sandrokleinbauer-lang/Test/lillabo-male-male/export/Gerade_MM.step

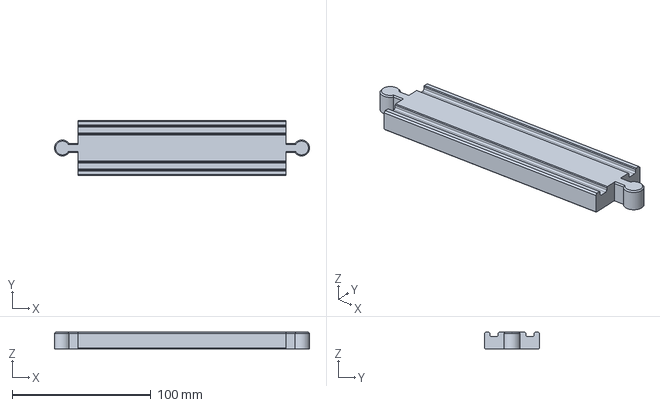
[picture p2: CAD file, 2026-10-17]
lillabo-male-male/export/Gerade_MM.step
184.0 x 40.0 x 12.0 mm
