sandrokleinbauer-lang/Test/lillabo-male-male/Lillabo_Stecker_Stecker.FCStd

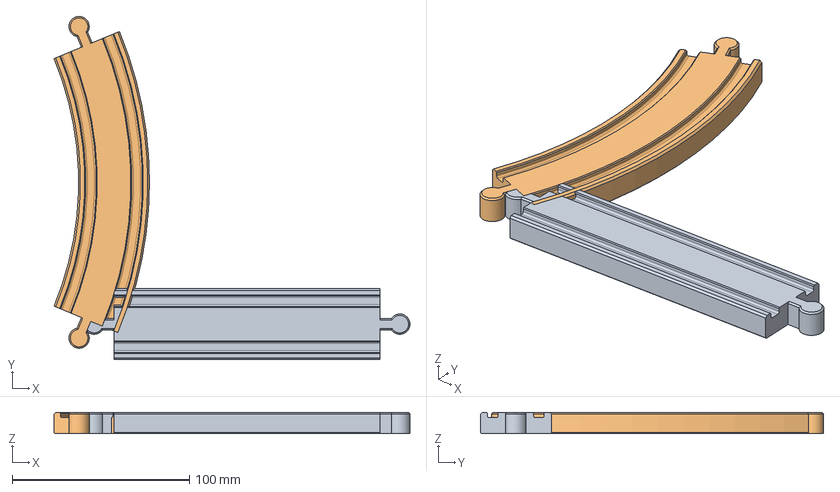
[picture p3: CAD file, 2026-10-17]
lillabo-male-male/Lillabo_Stecker_Stecker.FCStd
200.9 x 193.6 x 12.0 mm
Gerade_MM
Kurve_MM
