sandrokleinbauer-lang/Test/lillabo-male-male/export/Kurve_MM.step

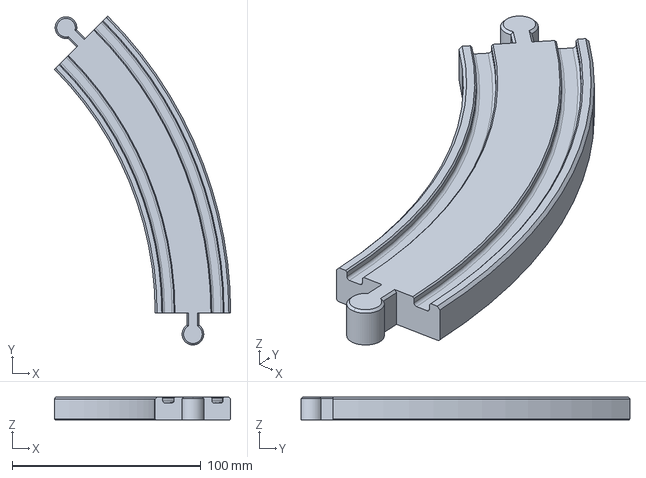
[picture p4: CAD file, 2026-10-17]
lillabo-male-male/export/Kurve_MM.step
93.5 x 174.3 x 12.0 mm
