sandrokleinbauer-lang/Test/lillabo-male-male/Lillabo_Stecker_Stecker_Platte.3mf

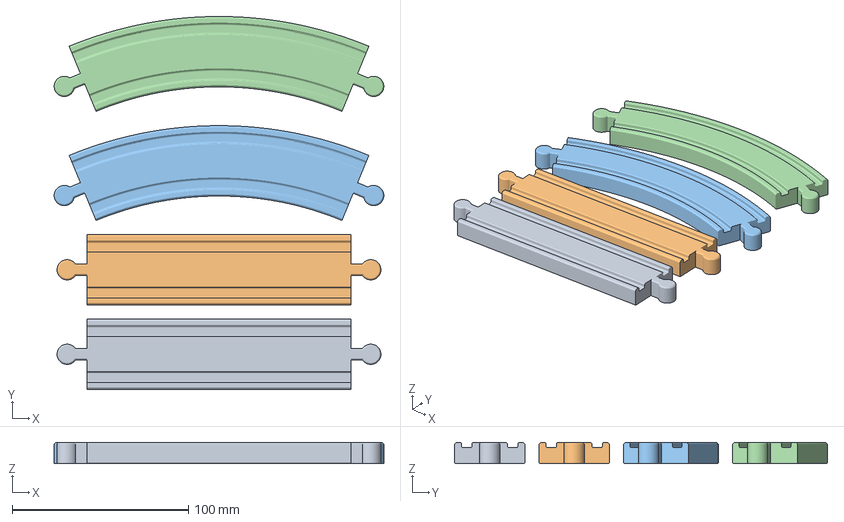
[picture p5: CAD file, 2026-10-17]
lillabo-male-male/Lillabo_Stecker_Stecker_Platte.3mf
187.3 x 211.9 x 12.0 mm
Gerade_MM_1
Gerade_MM_2
Kurve_MM_1
Kurve_MM_2
