sandrokleinbauer-lang/Test/(list of files, cad)

Other CAD files:
lillabo-male-male/export/Gerade_MM.stl
lillabo-male-male/export/Kurve_MM.stl
