sandrokleinbauer-lang/Test/(commit log)

2026-10-17 Lillabo-Schienen mit zwei Zapfen: FreeCAD-Modell, Exporte und Druckparameter
    Gerade (162 mm) und 45-Grad-Kurve (R 202,5 mm), jeweils mit maennlichem
    Anschluss an beiden Enden, damit die kleinen Kunststoffverbinder entfallen.
    Enthaelt parametrisches FreeCAD-Makro, FCStd, STEP/STL, fertig angeordnete
    3MF-Platte fuer den Bambu Lab P2S und README mit Massen und Druckparametern.
    Claude-Session: https://claude.ai/code/session_01DRTXcMBqP3jZZ9vDTZKxZy
    [Gerade_MM.step, Gerade_MM.stl, Kurve_MM.step, Kurve_MM.stl, Lillabo_Stecker_Stecker.FCStd, Lillabo_Stecker_Stecker_Platte.3mf]
2026-10-17 Gerade auf 150 mm und Zapfen auf 17 mm angepasst
    Masse an der echten Lillabo-Schiene nachgemessen. FCStd, STEP/STL,
    3MF-Platte, Vorschau und README neu erzeugt.
    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
    [Gerade_MM.step, Gerade_MM.stl, Kurve_MM.step, Kurve_MM.stl, Lillabo_Stecker_Stecker.FCStd, Lillabo_Stecker_Stecker_Platte.3mf]
